thunder439/QNAS4/QNAS4电路图.jpg

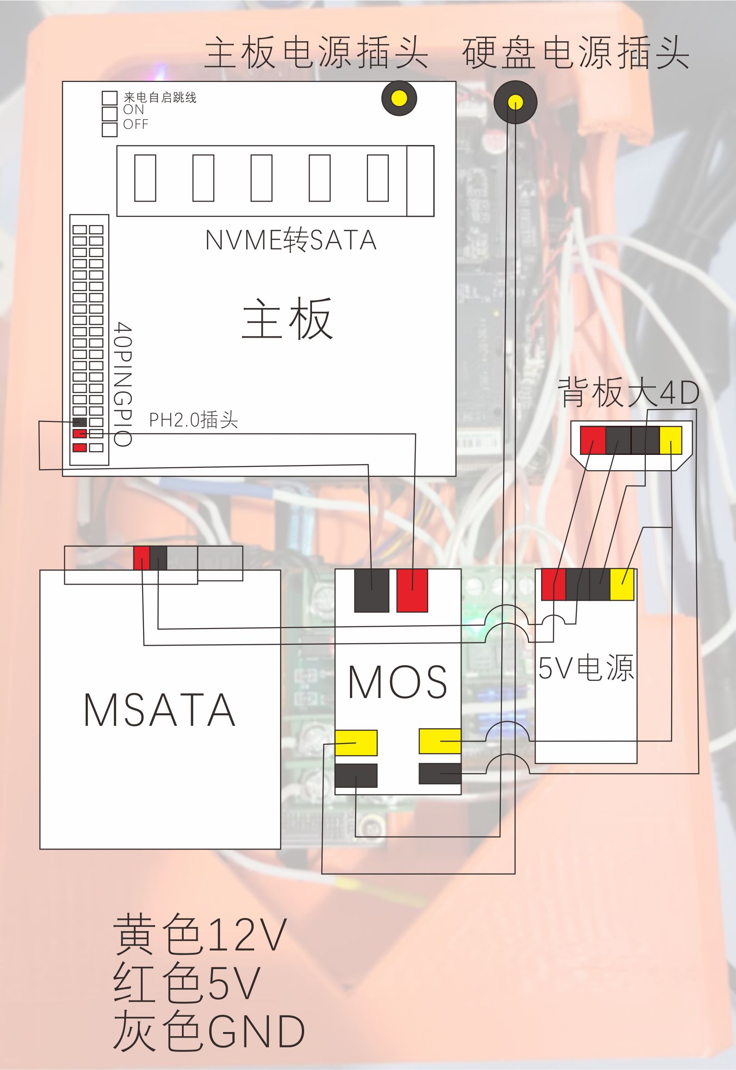
QNAS4电路图.jpg
