thunder439/QNAS4/jpg/IMG_036.jpg

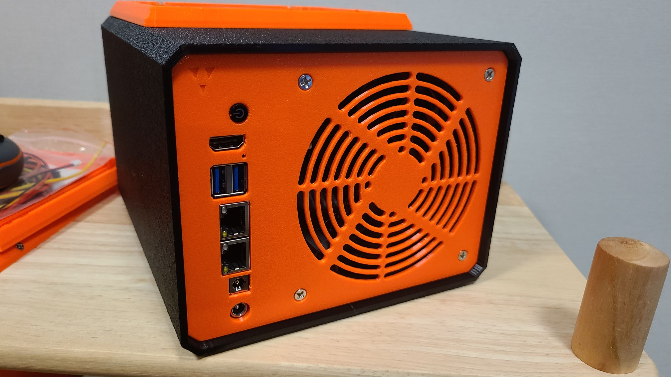
jpg/IMG_036.jpg
