thunder439/QNAS4/README.md

# QNAS4
 QNAS4是一个4盘位NAS的3D打印DIY方案

QNAS4采用3D打印的外壳可以满足个性化DIY需求

视频地址：
https://www.bilibili.com/video/BV1Kg411z7EG/

首页
