thunder439/QNAS4/stl/readme.md

2022.11.15
更新内框镂空结构 更好打印 
外壳脚垫更新到40*20MM 价格低

2022.11.16
更新外壳和内框的磁铁限位 让磁铁往内移动1MM

2022.11.18
更新外壳和内框的磁铁限位 让磁铁往内移动1MM
取消内框的铜嵌件孔位 因为打印件收缩孔位对不准 改成电钻打孔

2022.11.19
硬盘笼一侧的铜嵌件通道略微加厚 以提高螺丝固定强度

2022.11.24
主板区域风道优化 让气流更多的流过主板散热器

2023.2.14
硬盘笼固定螺丝孔缩小 放弃铜嵌件 采用自攻
图纸孔位缩小到2.8MM直径  FDM打印尺寸估计在2.4MM 

2023.3.22
更新优化细节。M2扩展卡锁尾螺丝孔周围壁厚加1MM，增加强度防止开裂。
修改硬盘供电5525孔位的免支撑设计，不再使用搭桥，改用45度倒角设计。

2023.4.1
增加一款水滴版硬盘笼，减少镂空面积，提高打印成功率。

2023.5.4
根据网友反馈进一步优化CPU风道。修改了内框出风口的位置。

2023.5.6
增加一款无孔硬盘笼，删除侧面镂空，提高打印速度。同时优化了一下滑轨底部的悬垂，提高细节打印质量。

2023.6.8
修改内框细节，提高打印质量。
