thunder439/QNAS4/群辉引导办法.docx

https://wjz304.github.io/Redpill_CustomBuild/Issues.html?dev=1

在线编译引导网址

表格内数据修改为自己的U盘的VID PID

DISKIDMAP和SATAPORTMAP如下图 适合JMB585

选IGC驱动

提交即可

等10分钟去下载编译好的映像文件 写入U盘即可

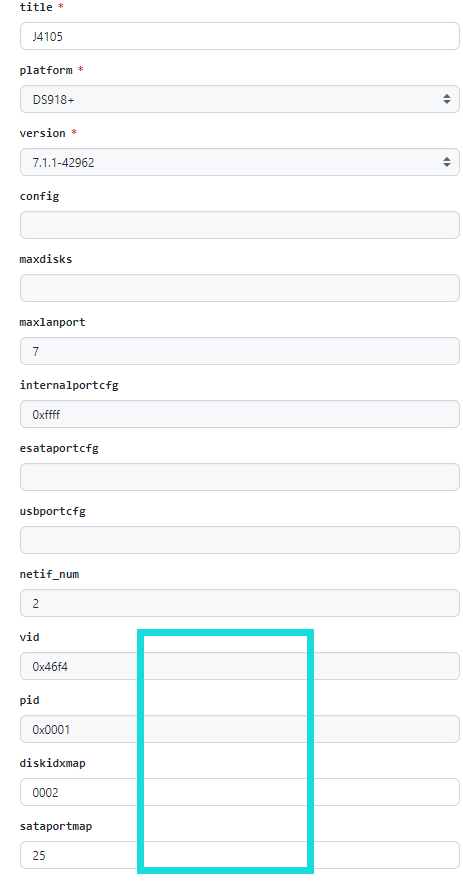
[picture p3: figure]
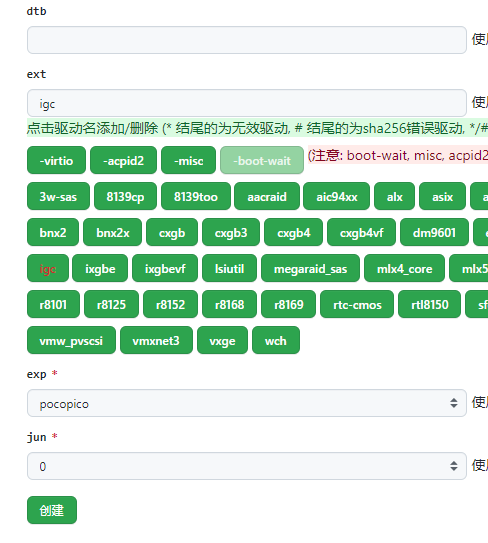
[picture p4: figure]
