thunder439/QNAS4/群晖现成引导文件使用说明.docx

U盘引导盘在刷之前，按照做在DSM6.X的方法，先用ChipEasy或者ChipGenius软件读取U盘的vid、pid这两个参数，在Windows系统的电脑上用OSFMount或者Diskgenius加载DS918-7.01的引导IMG文件后，把boot/grub/grub.cfg这个文件复制到桌面，用Notepad++进行修改（不要直接用记事本来编辑，否则格式错乱会造成群晖无法正常启动！），需要修改的地方有：

（1，必改）vid的值，改成用ChipEasy软件读取到U盘的vid这个参数，0x开头要保留不可以删除；

（2，必改）pid的值，改成用ChipEasy软件读取到U盘的pid这个参数，0x开头要保留不可以删除；

（3）sn的值，可以不改，如果有洗白码的改成洗白码sn的值。

（4）mac1的值，可以不改，或者可以改成物理网卡实际的mac值，如果有洗白码的改成洗白码mac1的值，如果实际使用双网卡的可以添加mac2的值，以此类推；

（5）netif_num的值，单网卡为1，双网卡为2，以此类推；

（6，控制器的值，必改）默认已改好JMB585

改好后保存拖进去替换原文件即可

最后使用写盘软件写入U盘

或者先写U盘， 然后使用Diskgenius从U盘里面提取文件修改， 再替换。

工具下载地址

https://dl.gxnas.com:1443/?dir=/%E9%BB%91%E7%BE%A4%E6%99%96/%E5%B7%A5%E5%85%B7
