thunder439/QNAS4/jpg/IMG_015.jpg

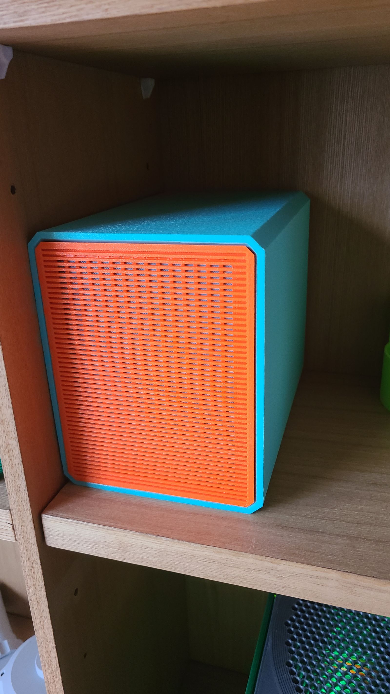
jpg/IMG_015.jpg
