thunder439/QNAS4/jpg/IMG_016.jpg

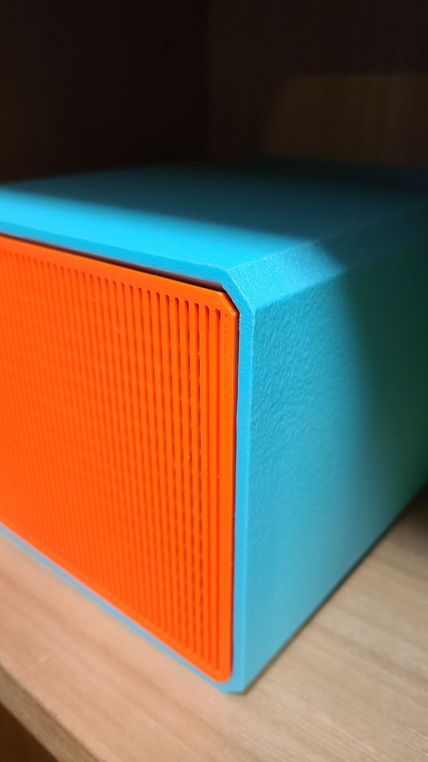
jpg/IMG_016.jpg
