thunder439/QNAS4/jpg/IMG_017.jpg

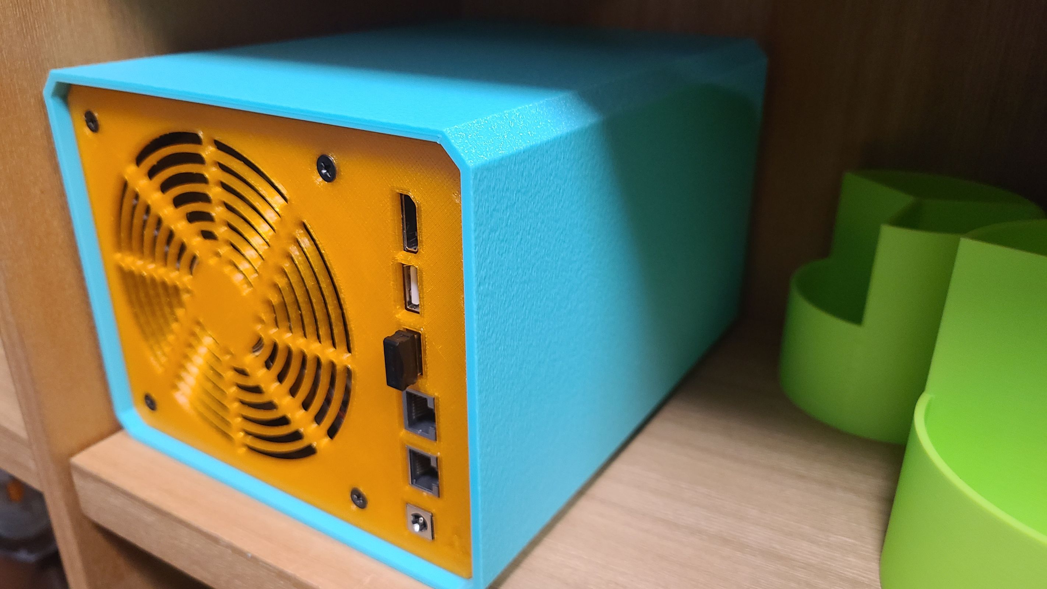
jpg/IMG_017.jpg
