thunder439/QNAS4/jpg/IMG_018.jpg

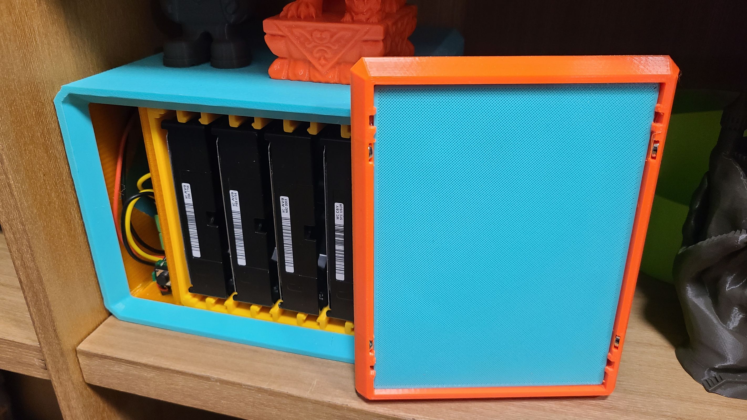
jpg/IMG_018.jpg
