thunder439/QNAS4/jpg/IMG_019.jpg

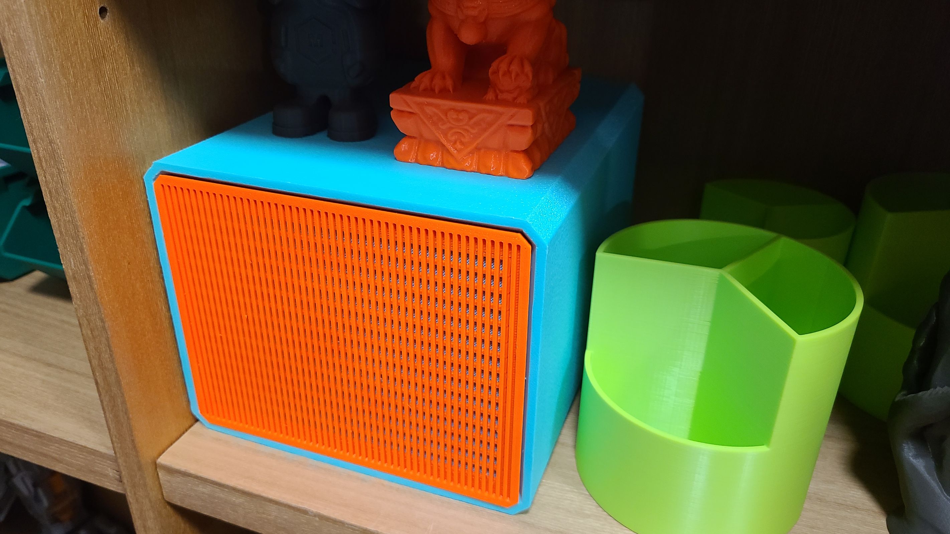
jpg/IMG_019.jpg
