thunder439/QNAS4/jpg/IMG_020.jpg

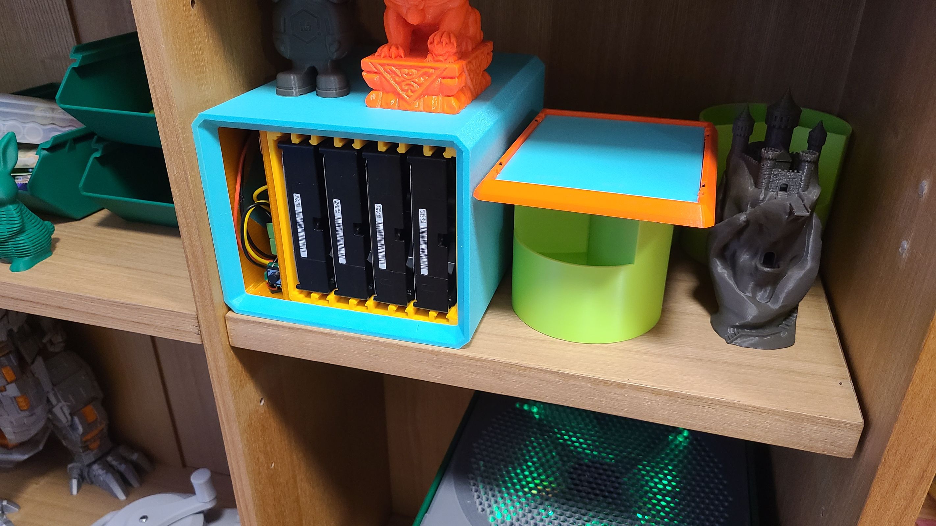
jpg/IMG_020.jpg
