thunder439/QNAS4/jpg/IMG_022.jpg

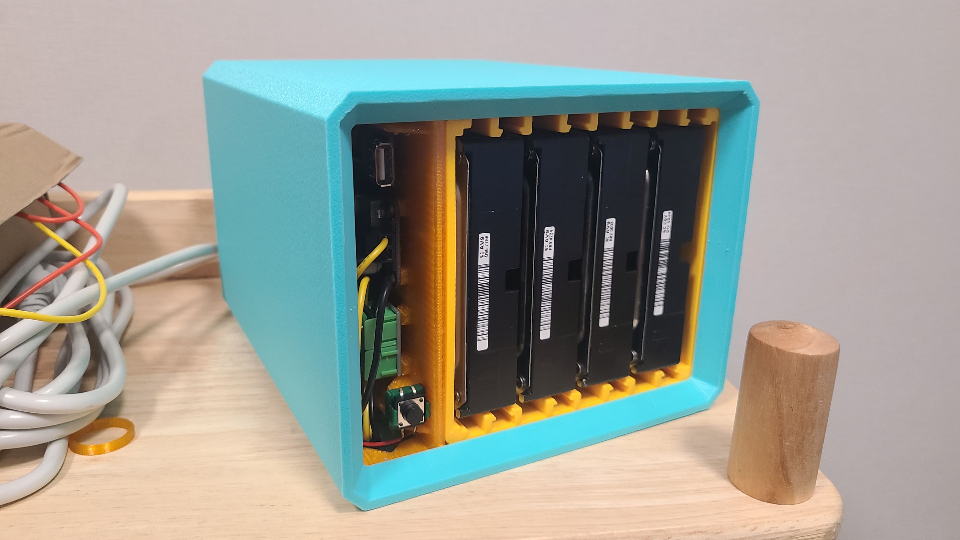
jpg/IMG_022.jpg
