thunder439/QNAS4/jpg/IMG_023.jpg

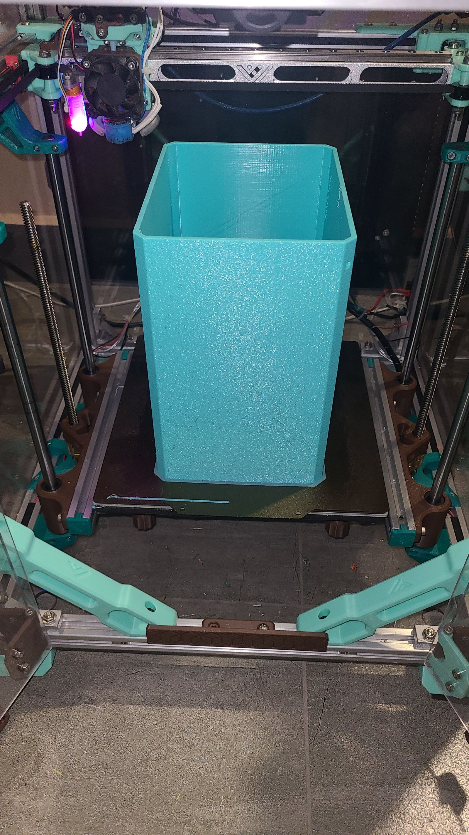
jpg/IMG_023.jpg
