thunder439/QNAS4/jpg/IMG_024.jpg

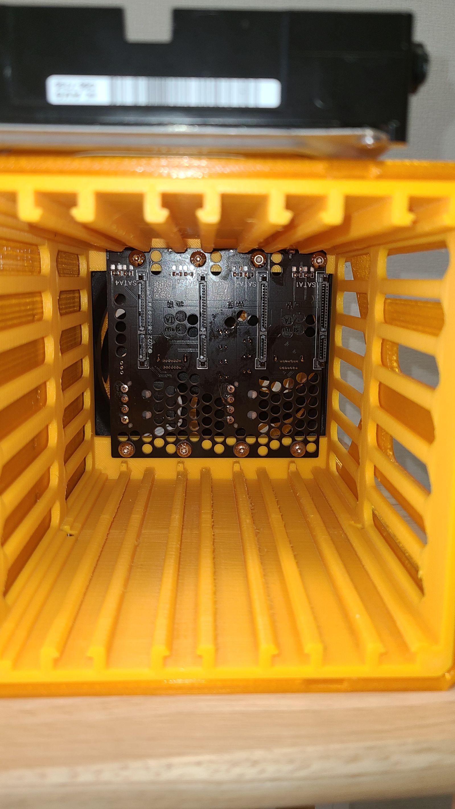
jpg/IMG_024.jpg
