thunder439/QNAS4/jpg/IMG_033.jpg

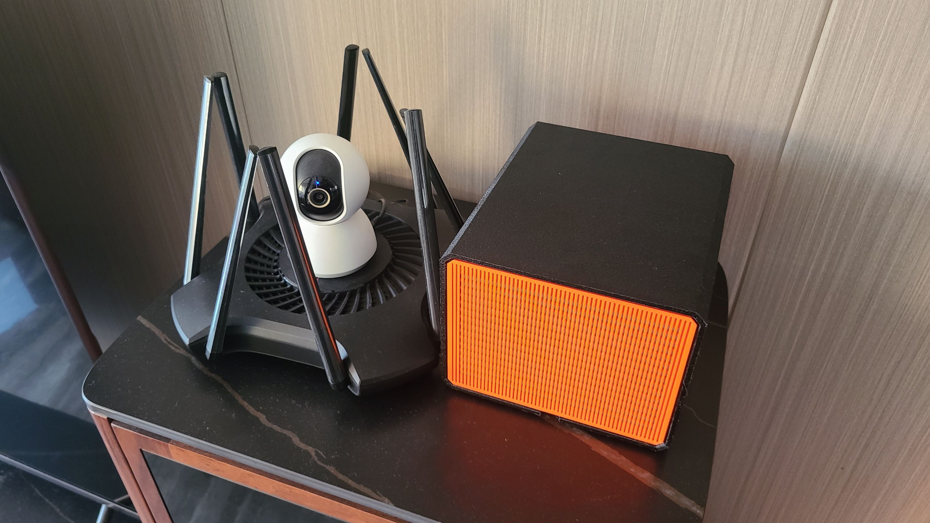
jpg/IMG_033.jpg
