thunder439/QNAS4/jpg/IMG_034.jpg

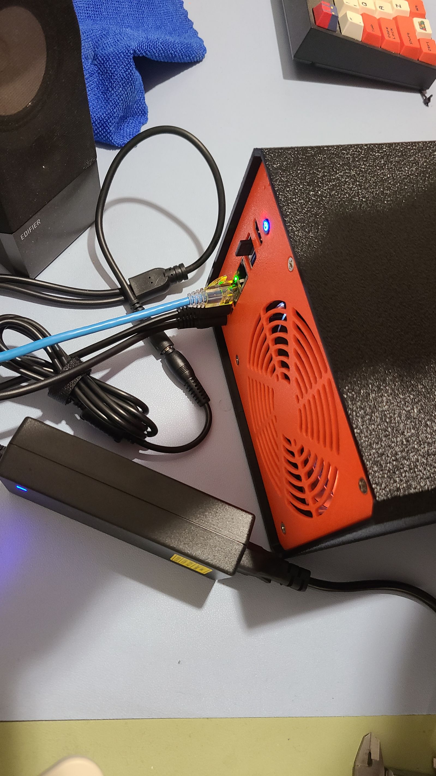
jpg/IMG_034.jpg
