thunder439/QNAS4/jpg/IMG_035.jpg

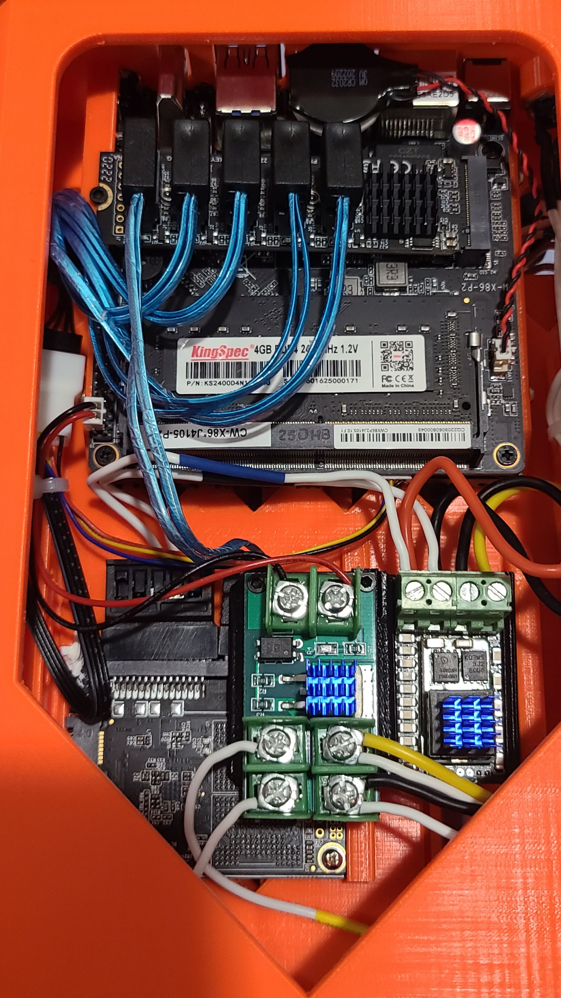
jpg/IMG_035.jpg
