thunder439/QNAS4/jpg/IMG_038.jpg

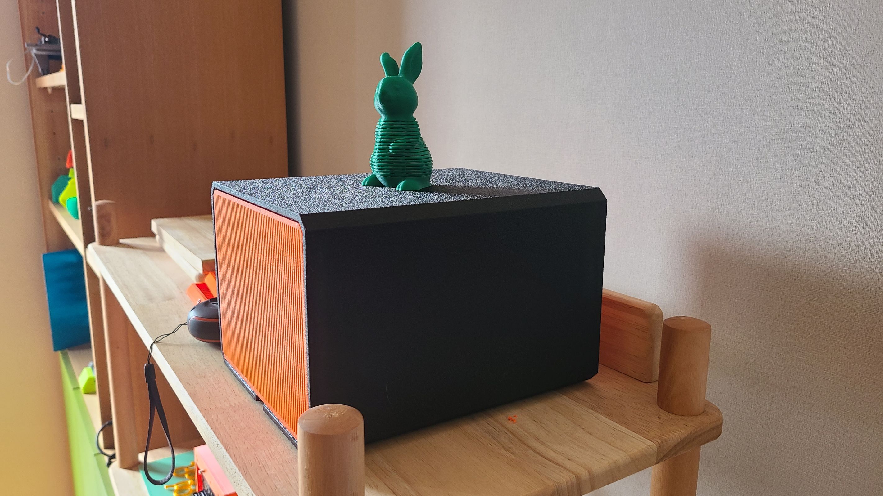
jpg/IMG_038.jpg
