thunder439/QNAS4/jpg/IMG_039.jpg

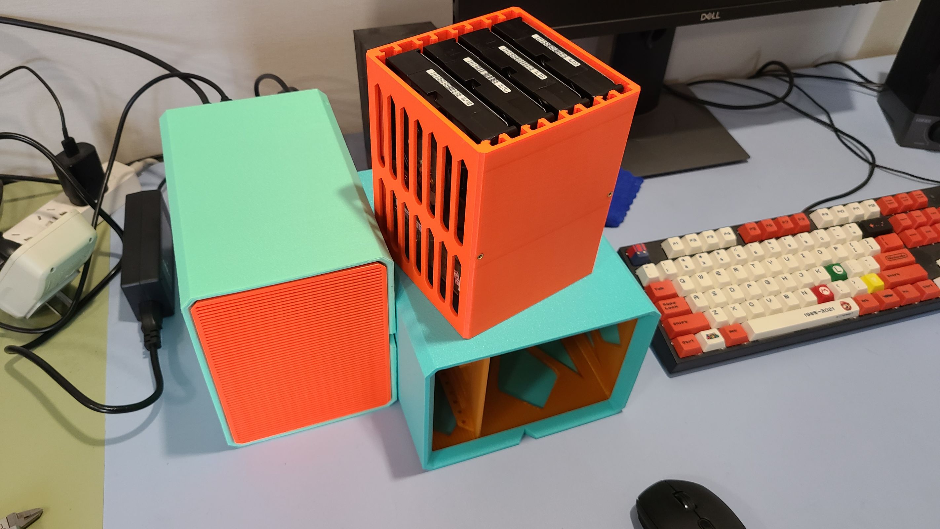
jpg/IMG_039.jpg
