thunder439/QNAS4/stl/内框20230608.STL

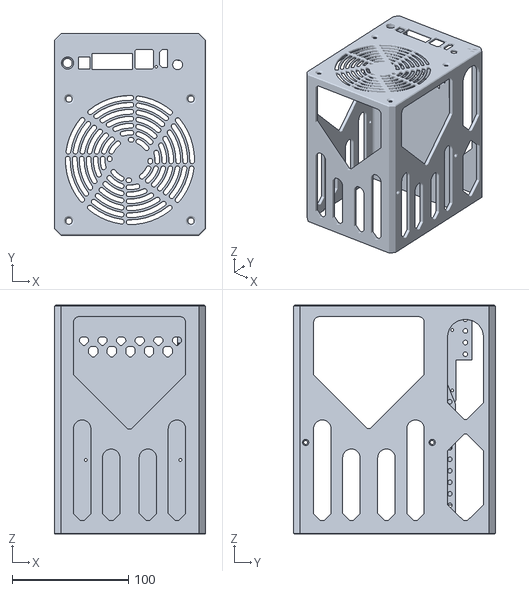
[picture p19: CAD file, 2023-06-08]
stl/内框20230608.STL
130.0 x 173.3 x 197.0
