thunder439/QNAS4/stl/硬盘笼无孔版20230506.STL

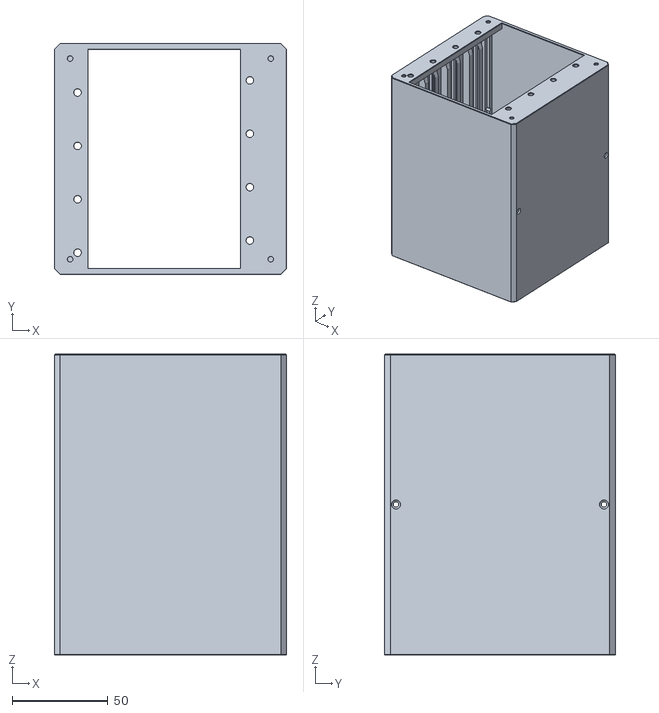
[picture p20: CAD file, 2023-05-06]
stl/硬盘笼无孔版20230506.STL
121.4 x 120.7 x 157.5
