thunder439/QNAS4/stl/V型面框.STL

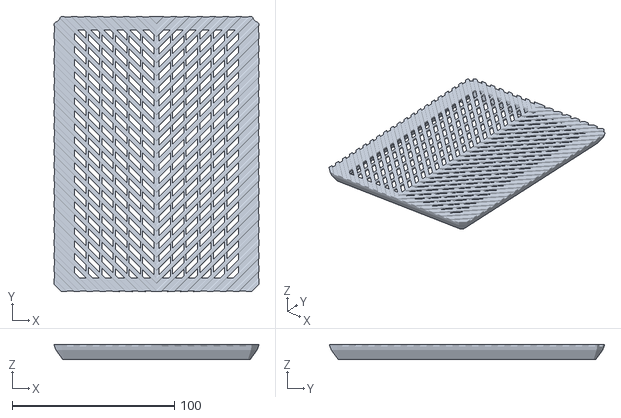
[picture p21: CAD file, 2023-04-23]
stl/V型面框.STL
126.5 x 169.9 x 9.50
