thunder439/QNAS4/stl/面盖.STL

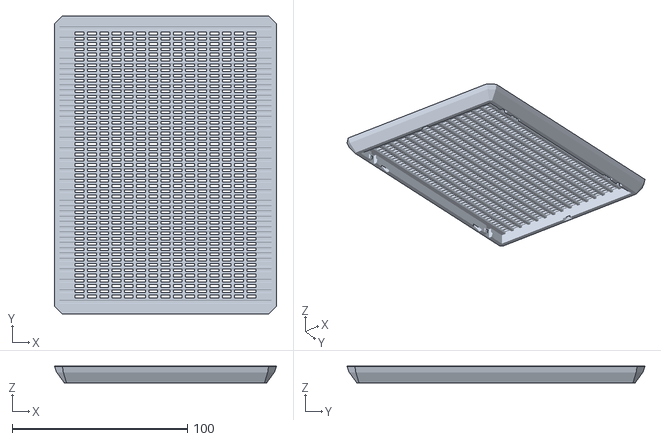
[picture p22: CAD file, 2023-04-14]
stl/面盖.STL
126.7 x 170.0 x 9.50
