thunder439/QNAS4/stl/硬盘笼水滴版20230401.STL

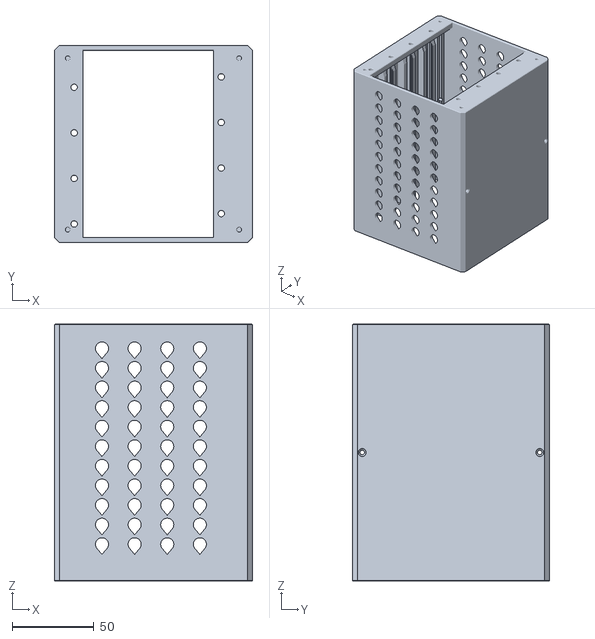
[picture p23: CAD file, 2023-04-14]
stl/硬盘笼水滴版20230401.STL
121.4 x 120.7 x 157.5
