thunder439/QNAS4/stl/硬盘戒指.STL

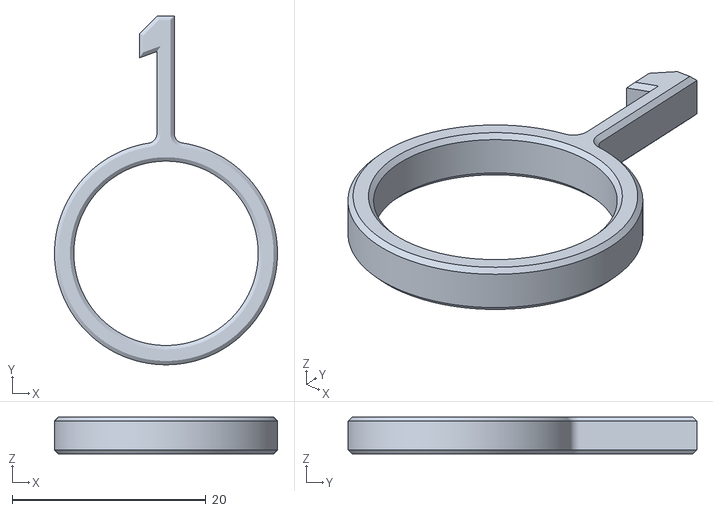
[picture p24: CAD file, 2023-04-14]
stl/硬盘戒指.STL
23.0 x 36.0 x 3.80
