thunder439/QNAS4/stl/外壳立式20221116.STL

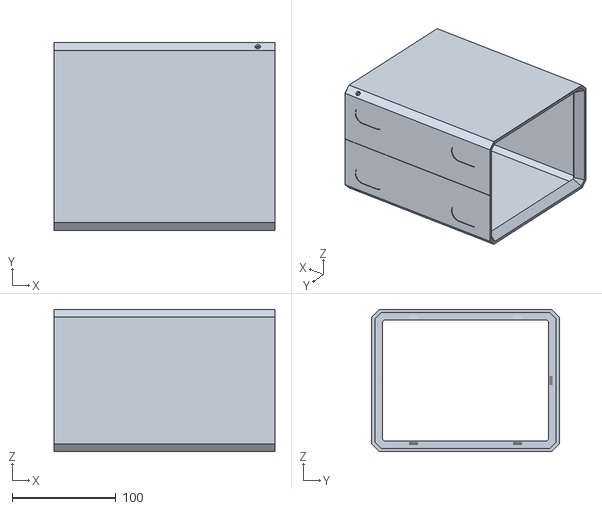
[picture p25: CAD file, 2023-04-14]
stl/外壳立式20221116.STL
212.5 x 180.3 x 137.0
