thunder439/QNAS4/stl/硬盘笼20221119.STL

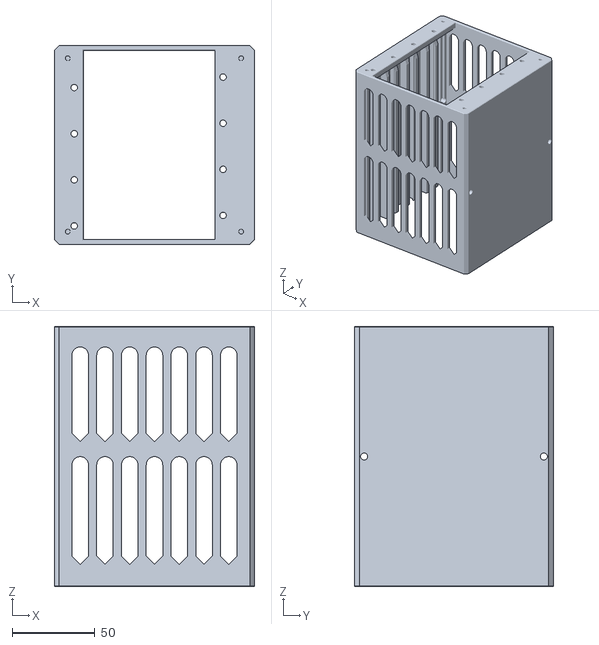
[picture p26: CAD file, 2023-04-14]
stl/硬盘笼20221119.STL
121.4 x 120.7 x 157.5
