thunder439/QNAS4/stl/电源转换板示例.STL

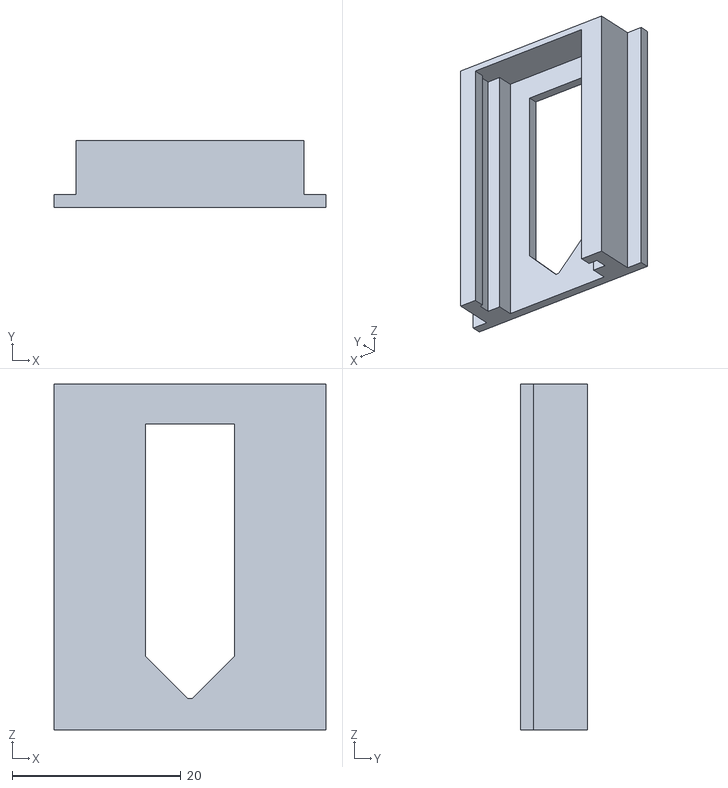
[picture p27: CAD file, 2023-04-14]
stl/电源转换板示例.STL
32.2 x 7.90 x 41.0
