thunder439/QNAS4/stl/3MM防尘.STL

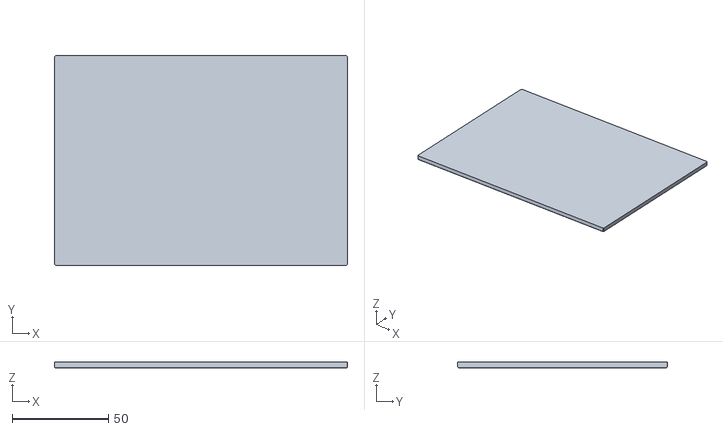
[picture p28: CAD file, 2023-04-14]
stl/3MM防尘.STL
152.2 x 108.9 x 3.00
