thunder439/QNAS4/stl/电源转换板 10A模块加MOS.STL

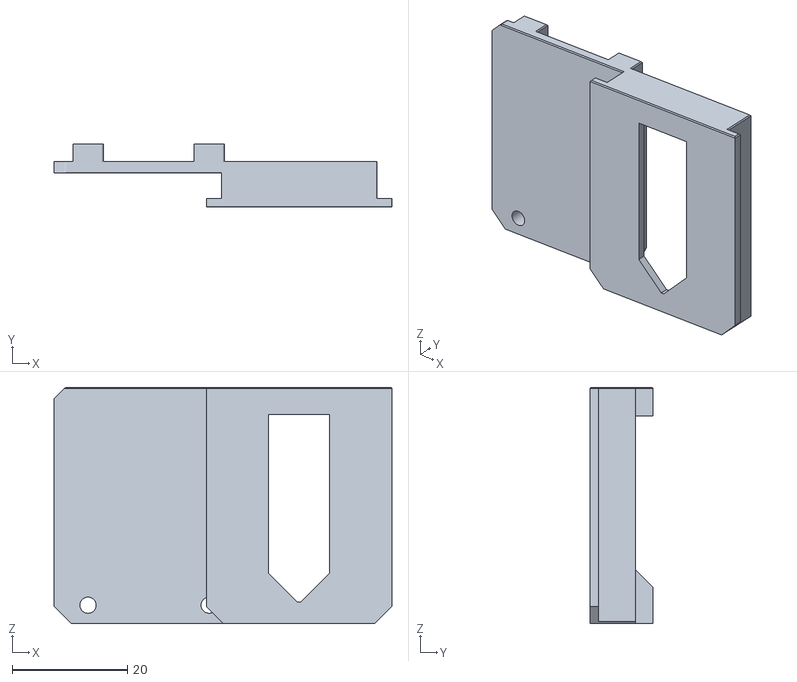
[picture p29: CAD file, 2023-04-14]
stl/电源转换板 10A模块加MOS.STL
58.6 x 10.9 x 41.0
