thunder439/QNAS4/stl/2.5寸SSD固定支架请自行镜像打印.STL

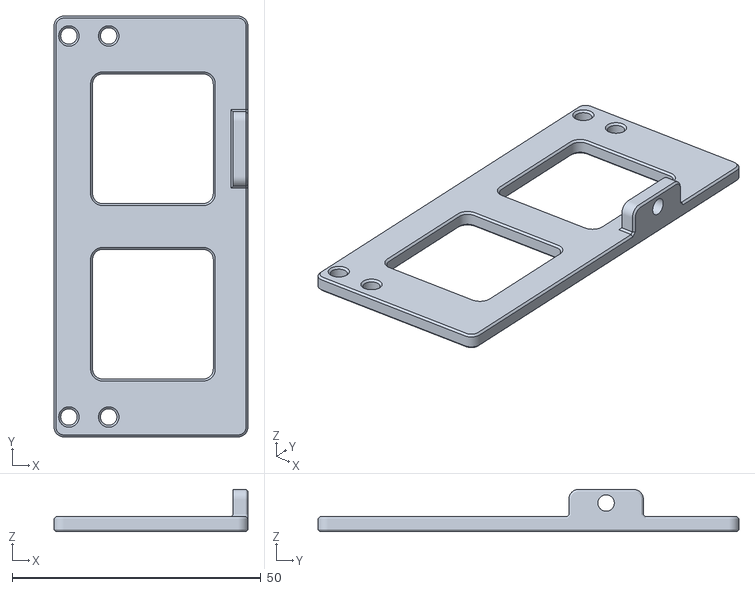
[picture p30: CAD file, 2023-04-14]
stl/2.5寸SSD固定支架请自行镜像打印.STL
39.0 x 84.6 x 8.50
