thunder439/QNAS4/(list of files, cad)

Other CAD files:
stl/外壳20221118.STL
stl/硬盘笼20230214.STL
