thunder439/QNAS4/(commit log)

2023-05-04 内框风道优化
    内框风道优化
    [内框20230504.STL]
2023-05-20 Add files via upload
    修复失效链接
    [BOM表材料购买清单20230520.xlsx]
